ttqq2330arch/hub75-pixel-clock/hardware/netlist.md

# ESP32-S3 HUB75 驱动板 — 接线表（手焊用）

> 本表与 `src/config.h` 的引脚定义一一对应（config.h 已经是 S3 安全引脚，已避开 26~37 / 19·20 USB / 0·3·45·46 strapping）。
> 模块 = **ESP32-S3-WROOM-1-N16R8**（18×25.5mm，两侧排针 2.54mm 间距）。

## 一、电源（红线/绿线）

| 来源 | 接到 | 线 |
|---|---|---|
| 外置 5V/5A 电源 + | J0 端子 5V、D1阳极、D2阳极、C1/C2 正端 | 红 |
| 外置 5V/5A 电源 − | J0 端子 GND、所有 GND 符号、屏 VH4 负极、C1/C2 负端 | 绿（**必须共地**） |
| 5V 轨 → U1(IN) | AMS1117-3.3 输入 | 红 |
| U1(OUT) → 3V3 轨 | ESP32 所有 VDD3P3 脚、上拉电阻、C3/C4 | 蓝 |
| U1(GND) | GND 轨 | 绿 |

> ⚠ 屏本身靠 **VH4 电源座** 单独接那个 5V/5A 电源，HUB75 排线**只走信号+GND**，不要从排线给屏供 5V。

## 二、ESP32-S3 关键脚 → 目标

| ESP32 脚 | 功能 | 接到 | 备注 |
|---|---|---|---|
| 1,2,3,4 (VDD3P3) | 3.3V | 3V3 轨 | 多脚并联，每脚就近 100nF |
| 5,6,7,8,9,10,11,12,13,14 (GND) | 地 | GND 轨 | 多脚并联 |
| GPIO0 | BOOT | SW1 一键 + 10k→3V3 | 上电采样，必须上拉 |
| EN (CHIP_PU) | 复位 | SW2 一键 + 10k→3V3 + 0.1µF→GND | 低电平复位 |
| GPIO45 | strapping | 10k→3V3 | **必须上拉**（决定 VDD_SPI=3.3V） |
| GPIO46 | strapping | 10k→GND | **必须下拉** |
| GPIO3 (RXD) | strapping | 10k→3V3 | 防误进下载 |
| GPIO19 | USB-D- | J1 USB-C D- | 原生 USB |
| GPIO20 | USB-D+ | J1 USB-C D+ | 原生 USB |
| GPIO2 | 状态 LED | 330Ω → LED → GND | 开机闪一下 |
| GPIO41 | I2C SDA | J3 SHT30 SDA | 可选温湿度 |
| GPIO42 | I2C SCL | J3 SHT30 SCL | 可选温湿度 |
| GPIO14 | 蜂鸣器 | BUZ + → GPIO14，BUZ − → GND | 可选整点报时 |

## 三、HUB75 信号（ESP32 GPIO → J2 排针，3.3V 直驱）

| config.h | ESP32 脚 | J2 针 | HUB75 信号 |
|---|---|---|---|
| PIN_R1 | GPIO4 | 1 | R1 |
| PIN_G1 | GPIO5 | 2 | G1 |
| PIN_B1 | GPIO6 | 3 | B1 |
| — | GND | 4 | GND |
| PIN_R2 | GPIO7 | 5 | R2 |
| PIN_G2 | GPIO15 | 6 | G2 |
| PIN_B2 | GPIO16 | 7 | B2 |
| — | GND | 8 | GND |
| PIN_A | GPIO17 | 9 | A |
| PIN_B | GPIO18 | 10 | B |
| PIN_C | GPIO8 | 11 | C |
| PIN_D | GPIO9 | 12 | D |
| PIN_E | GPIO10 | 13 | E |
| PIN_CLK | GPIO12 | 14 | CLK |
| PIN_LAT | GPIO11 | 15 | LAT/STB |
| PIN_OE | GPIO13 | 16 | OE |

> ⚠ **HUB75 排针顺序有两种常见排法**（本表是主流：1=R1 2=G1 …；少数屏是 1=GND 2=R1）。
> 焊之前先用万用表/看屏丝印核对针序，插反=不亮或烧输入缓冲。

### 三-附、用户现有母座板（原理图编号 J1）脚序 —— 2026-10-23 已定论

**屏侧（实测丝印 `panel_silk.jpg`）＝标准 HUB75**，连接器旁八行两列表为
`R1G1 / B1GND / R2G2 / B2E / AB / CD / CLKLAT / OEGND`，即：

| 屏针 | 1 | 2 | 3 | 4 | 5 | 6 | 7 | 8 | 9 | 10 | 11 | 12 | 13 | 14 | 15 | 16 |
|---|---|---|---|---|---|---|---|---|---|---|---|---|---|---|---|---|
| 信号 | R1 | G1 | B1 | **GND** | R2 | G2 | B2 | **E** | A | B | C | D | CLK | LAT | OE | **GND** |

**转接板母座 J1 ＝标准顺序但"奇偶脚两两互换"**（GND 在 3/15、CLK 在 16、OE 在 13）：

| 板针 | 1 | 2 | 3 | 4 | 5 | 6 | 7 | 8 | 9 | 10 | 11 | 12 | 13 | 14 | 15 | 16 |
|---|---|---|---|---|---|---|---|---|---|---|---|---|---|---|---|---|
| 信号 | G1 | R1 | **GND** | B1 | G2 | R2 | E | B2 | B | A | D | C | **OE** | LAT | **GND** | **CLK** |
| GPIO | 5 | 4 | — | 6 | 15 | 7 | 10 | 16 | 18 | 17 | 9 | 8 | 12 | 11 | — | 13 |

#### ⚠ 排线必须「翻插」（奇偶互换）

- **正插（1↔1）**：屏的 GND(4/16) 被 GPIO6/GPIO13 顶着，屏的 OE(15) 被板地拉低 → **OE 常开 + 蓝通道接地**
  ⇒ 现象＝**彩色全亮**。
- **翻插（1↔2、3↔4 …）**：GND 落回屏 4/16，R1/G1/B1/R2/G2/B2/E/A/B/C/D 全对，
  仅 CLK/LAT/OE 三根成环（板13→屏14、板14→屏13、板16→屏15）⇒ 现象＝**竖彩线、无法锁存**。
  → 这三根在固件里对调即可：`PIN_CLK=11`、`PIN_LAT=12`、`PIN_OE=13`（config.h 已按此设定）。

> 若将来改回"正插"，config.h 需恢复 `LAT=11 / OE=12 / CLK=13`。

#### 面板型号与驱动

- 丝印：`M89J27A7A04B2(78C)` / `64-32S-I-2121-2012-V2.1` → **64×64、1/32 扫、2121 LED**
- 行驱动 IC 丝印实测：**CHIPONE ICN2037**（`drv_zoom.png`）→ 列驱动同族，`cfg.driver` 用 **ICN2038S**

#### 上电前必查

1. 万用表蜂鸣：屏 4/16 针 ↔ 屏 VH4 座负极 ↔ ESP32 GND **三处全通**（翻插后靠排线 3/15 导地，建议再加一根粗线直连）。
2. 屏 5V 只走 VH4 电源座，不要从排线取电。
3. 排线红边对齐屏丝印 IN 口的 1 脚标记。

## 四、USB-C（J1）

| USB-C 脚 | 接到 |
|---|---|
| VBUS | D2(Schottky) → 5V 轨（与电源 OR） |
| D- | GPIO19 |
| D+ | GPIO20 |
| CC1, CC2 | 各串 5.1kΩ → GND（声明为受电设备） |
| GND | GND 轨 |

## 五、可选电平转换（仅当屏 3.3V 点亮花屏时加）

ESP32 GPIO(3.3V) → 74AHCT245 A 端；74AHCT245 B 端(5V) → J2。OE/GND，DIR→GND（A→B）。
VCC=5V 取自 5V 轨。一片 74AHCT245 只有 8 通道，13 线需 2 片（或仅数据 6 线过转换、控制线直驱试运气）。
