ttqq2330arch/hub75-pixel-clock/hardware/BOM.md

# BOM — ESP32-S3 HUB75 驱动板

> 价格区间 2026 年参考，嘉立创/立创商城 / 淘宝均可。除模块与屏外，其余几十元搞定。

## 核心

| 位号 | 名称 | 型号 | 数量 | 备注 |
|---|---|---|---|---|
| U2 | ESP32-S3 模组 | ESP32-S3-WROOM-1-N16R8 | 1 | 16MB Flash+8MB PSRAM；买**模组**非开发板 |
| J2 | HUB75 座 | 2×8 2.54mm 排母/排针 | 1 | 公母看你接屏线；建议母座 |
| J0 | 5V 电源端子 | 2P 螺丝端子 5.08mm | 1 | 接外置 5V/5A |
| J1 | USB-C 座 | 16P SMD 贴片 | 1 | 烧录+供电 |

## 电源

| 位号 | 名称 | 型号 | 数量 | 备注 |
|---|---|---|---|---|
| U1 | LDO 3.3V | AMS1117-3.3 (SOT-223) | 1 | 或 AP2112K-3.3 |
| D1, D2 | 肖特基二极管 | SS14 (SMA) | 2 | 5V 双电源 OR 防倒灌 |
| C1 | 电解 | 1000µF/25V | 1 | 屏功率缓冲，**靠近 J0** |
| C2 | 陶瓷 | 0.1µF 0805 | 1 | 电源高频去耦 |
| C3 | 陶瓷/电解 | 10µF 0805 | 1 | 3V3 去耦 |
| C4 | 陶瓷 | 100nF 0805 | 1 | 3V3 去耦 |

## 外围

| 位号 | 名称 | 型号 | 数量 | 备注 |
|---|---|---|---|---|
| SW1 | 轻触开关 | 4×4×1.5mm | 1 | BOOT（下载/切盘） |
| SW2 | 轻触开关 | 4×4×1.5mm | 1 | EN 复位 |
| R | 电阻 | 10kΩ 0805 | 4 | GPIO0/45/3 上拉、GPIO46 下拉（或 1 上拉 3 下拉组合） |
| R(CC) | 电阻 | 5.1kΩ 0805 | 2 | USB-C CC1/CC2 |
| R(LED) | 电阻 | 330Ω 0805 | 1 | LED 限流 |
| D3 | LED | 0805 红/绿 | 1 | 状态指示 |
| — | 排针/排母 | 2.54mm | 若干 | 模块焊接/测试点 |

## 可选

| 位号 | 名称 | 型号 | 数量 | 备注 |
|---|---|---|---|---|
| J3 | 温湿度 | SHT30 (DFN/QFN 转接板) | 1 | 显示温湿度 |
| BUZ | 蜂鸣器 | 无源 5V 贴片 | 1 | 整点报时 |
| U3/U4 | 电平转换 | 74AHCT245 | 2 | 仅 3.3V 驱动花屏时加 |

## 外部（不在此板）

| 名称 | 规格 | 备注 |
|---|---|---|
| 电源 | 5V/≥5A 开关电源 | 全白峰值近 4A，留余量 |
| HUB75 屏 | P2.5 64×64（你的微雪屏） | VH4 座单独接 5V/5A |
| 排线 | HUB75 16P 灰排线 | 插面板 IN 端 |
