ttqq2330arch/hub75-pixel-clock/hardware/pcb/_wiring_3v3.txt

  (wiring
    (net 3V3
      (wire
        (path B.Cu 3000
          22700 -44200 34500 -56000 274000 -56000
        )
      )
    )
  )
