ttqq2330arch/hub75-pixel-clock/(list of files, drawings)

Other design files:
hardware/pcb/_blank.dsn
hardware/pcb/_ref_routed.dsn
hardware/pcb/_test_plane.dsn
hardware/pcb/_test_power.dsn
hardware/pcb/_test_rulearea.dsn
hardware/pcb/_test_wiring.dsn
hardware/pcb/hub75-adapter-1l-c120.dsn
hardware/pcb/hub75-adapter-1l.dsn
hardware/pcb/hub75-adapter-2layer.dsn
hardware/pcb/hub75-adapter.dsn
