ttqq2330arch/hub75-pixel-clock/hardware/pcb/hub75-adapter.kicad_pcb

## KiCad design hardware/pcb/hub75-adapter.kicad_pcb (2026-10-29)

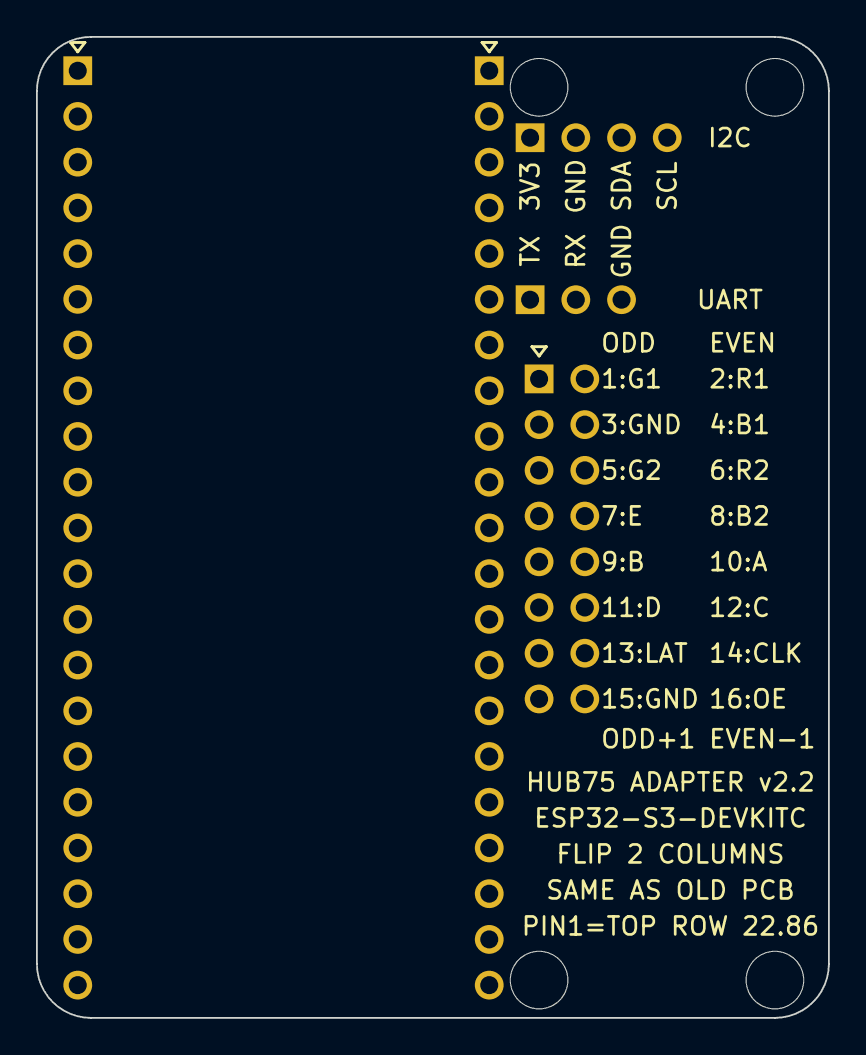
[picture p7: board hub75-adapter.kicad_pcb from above]

Board: 2 copper layers, 44.0 x 54.5 mm, 9 parts (0 on the bottom side), 20 nets, no tracks yet.

Parts:
H1, H2, H3, H4: MountingHole_3.2mm
J1: Socket_1x22_L
J2: Socket_2x8_HUB75
J3: Socket_1x22_R
J4: PinHeader_1x4
J5: PinHeader_1x3

Connections:
3V3: J1.1, J1.2, J4.1
A: J1.10, J2.10
B: J1.11, J2.9
B1: J1.6, J2.4
B2: J1.9, J2.8
C: J1.12, J2.12
CLK: J1.17, J2.14
D: J1.15, J2.11
E: J1.16, J2.7
G1: J1.5, J2.1
G2: J1.8, J2.5
GND: J2.3, J2.15, J3.1, J3.21, J4.2, J5.3
LAT: J1.18, J2.13
OE: J1.19, J2.16
R1: J1.4, J2.2
R2: J1.7, J2.6
SCL: J3.6, J4.4
SDA: J3.7, J4.3
URX: J3.3, J5.2
UTX: J3.2, J5.1
