ttqq2330arch/hub75-pixel-clock/(commit log)

2026-10-29 Initial open-source release v0.3.23: ESP32-S3 HUB75 64x64 pixel clock firmware (web console, watch-face store, screen rotation, WiFi switching)
2026-10-29 feat: publish WeChat miniprogram control app + fix dead BLE channel
    - Restore miniprogram/ to the public repo (was gitignored as 'deprecated')
    * 46 files: 5 pages (home/dials/store/detail/devices) + utils (api/render/ble/faces) + 6 local pixel watch-faces
    - Fix dead BLE channel: firmware ENABLE_BLE=0 means ble_service.cpp is not
    compiled at all, so the board advertises no GATT service and the miniprogram
    scan always fails. Now gated behind BLE_ENABLED=false in home.js/devices.js
    (hidden UI + accurate offline hint); flipping firmware ENABLE_BLE=1 and
    BLE_ENABLED=true revives it with no other frontend changes.
    - README: add miniprogram section (features, 3-step setup, API reuse, FAQ,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
2026-10-29 feat: add native Android app (Kotlin + Compose) for personal use
    Native Android client for the HUB75 pixel clock — not a WebView wrapper.
    Why native instead of another web page:
    - mDNS auto-discovery via NsdManager: finds 'pixelclock-02.local' on the LAN
    without typing an IP, and survives the board getting a new DHCP lease
    (verified: pixelclock-02.local -> 192.168.1.46)
    - Plain HTTP on the LAN needs no TLS; network_security_config.xml permits
    cleartext only for RFC1918 + .local, everything else still requires HTTPS
    - Direct LittleFS table-push (.rgb565 multi-frame) and file picking
    Features: control console (status / signal / brightness / 4-way rotation /
    face store / builtin faces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
2026-10-29 fix(android): 修复 APP 连不上板子（明文放行 + mDNS 组播锁 + 连接诊断）
    问题：APP 安装后无法连接像素时钟。根因有三个，其中前两个是致命的。
    1. network_security_config.xml 的 <domain> 不是 CIDR 网段
    原来写 <domain>192.168.1.0</domain> 指望放行整个 /24，
    但 Android 按【主机名后缀】匹配，192.168.1.46 匹配不上，
    系统直接抛 "Cleartext HTTP traffic to 192.168.1.46 not permitted"。
    板子 IP 由 DHCP 分配会变，也无法穷举成 domain 列表，
    改为在 base-config 层放行明文（IoT 控制 APP 标准做法）。
    公网 HTTPS 仍照常校验系统 CA。
    2. mDNS 发现从未持有组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
2026-10-30 feat(android): 新增叠加时钟位置调整（拖拽预览）
    用户需求：APP 里要能调整表盘上时钟的位置。
    实现方式：纯 APP 侧，不动固件——固件的 /dialov 接口本来就完整支持
    位置/样式/字号/颜色/开关，只是 APP 从来没做过界面。
    功能：
    - 表盘库每个卡片新增「调时钟」按钮 → 打开调整对话框
    - 64x64 预览图（表盘真实首帧 + 参考网格），直接拖动橙色框移动时钟
    - 样式：经典文本 / 方块数字；字号：大/小；颜色：白/黑/黄；叠加显示开关
    - 「恢复默认」回到 居中 + 大字号 + 白色 + 经典文本
    顺手修 bug：BoardClient.dialOverlay() 三个参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
2026-10-30 feat(android): 新增「工坊」页内嵌像素图片生成器并一键直推设备
    - 将用户的 HUB75 像素图片生成器搬入 APP（assets/studio.html）
    - WebView + @JavascriptInterface 桥（StudioBridge）代管 HTTP 推送
    - DeviceHttp 复用已连板子地址，规避明文 HTTP + CORS 限制
    - 底部导航新增「工坊」图标（共 4 个页面）
    - 新增 DeviceHttpTest 单元测试，全部测试通过
    - 更新 README 与 docs 预览图
